pettym/Carolinacon-19-Badge/plugins/README.org

#+STARTUP: showall

* Setup
 - Create symlink in kicad's plugin directory
 - ~ln -s "$(pwd)/nfc_antenna_plugin.py ~/.local/share/kicad/6.0/scripting/plugins~
 - Run the plugin from pcbnew:
 -
