pettym/Carolinacon-19-Badge/cc-19-badge.kicad_sch

## KiCad design cc-19-badge.kicad_sch (2023-11-18)

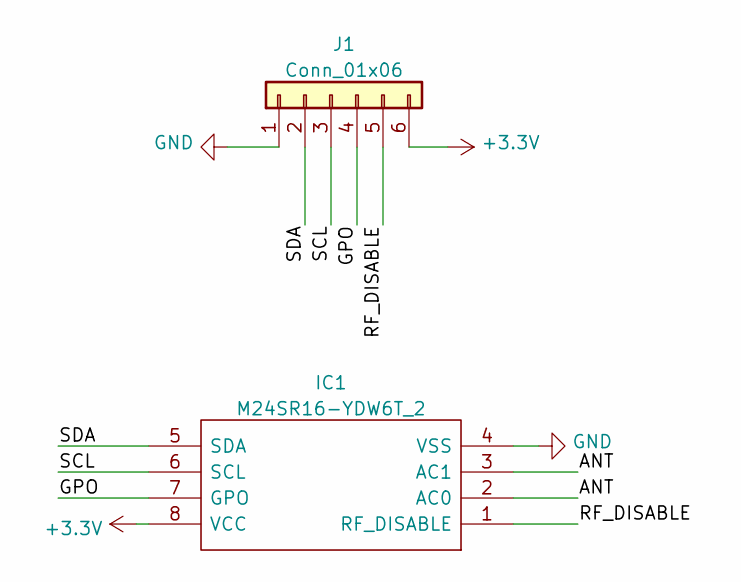
[picture p1: schematic cc-19-badge.kicad_sch]

Parts:
IC1: M24SR16-YDW6T_2; SOP65P640X120-8N; Mouser Part Number 511-M24SR16-YDW6T/2
J1: Conn_01x06; PinHeader_1x06_P2.54mm_Vertical

Connections:
+3.3V: IC1.8 (VCC), J1.6
ANT: IC1.2 (AC0), IC1.3 (AC1)
GND: IC1.4 (VSS), J1.1
GPO: IC1.7 (GPO), J1.4
RF_DISABLE: IC1.1 (RF_DISABLE), J1.5
SCL: IC1.6 (SCL), J1.3
SDA: IC1.5 (SDA), J1.2
