pettym/Carolinacon-19-Badge/(commit log)

2023-11-18 Squash commits
    [cc-19-badge.kicad_pcb, cc-19-badge.kicad_sch]
2023-11-18 59 update pipeline to use submodule for schematics (#60)
    update readme
2023-11-19 add thumbnails of test boards
